ChrisDelta3Robotics/ESPiderman/STEP/BodyLid.step

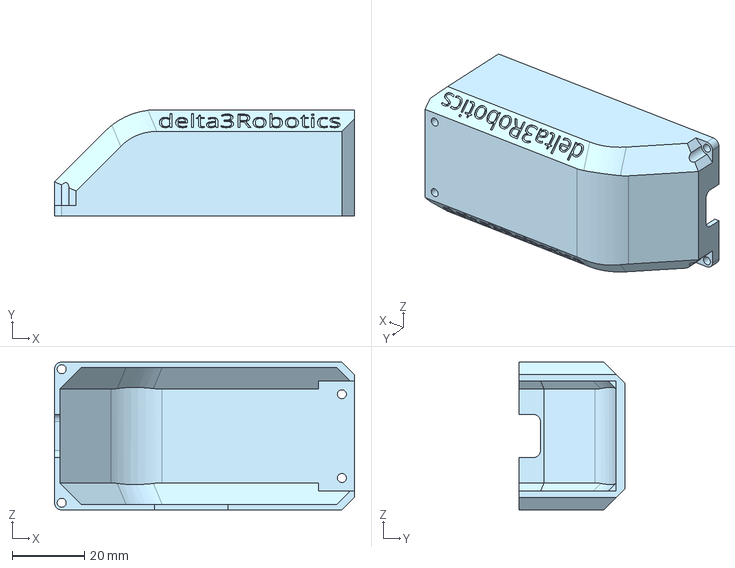
[picture p25: CAD file, 2025-09-30]
STEP/BodyLid.step
83.1 x 29.5 x 41.0 mm
