ChrisDelta3Robotics/ESPiderman/STL/cap2.stl

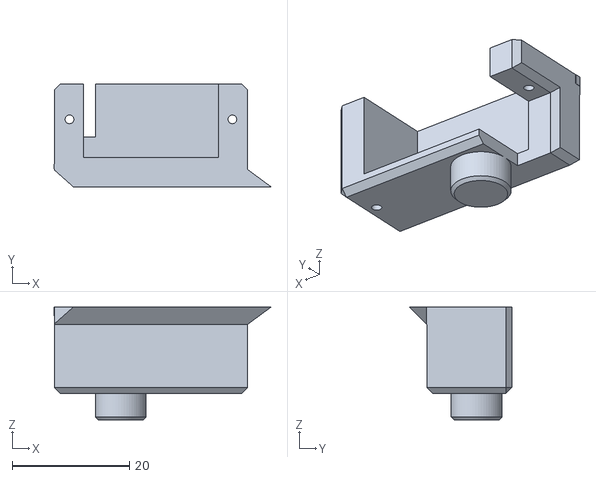
[picture p26: CAD file, 2025-09-30]
STL/cap2.stl
37.0 x 17.5 x 19.2
