ChrisDelta3Robotics/ESPiderman/STEP/Leg_OuterPart.step

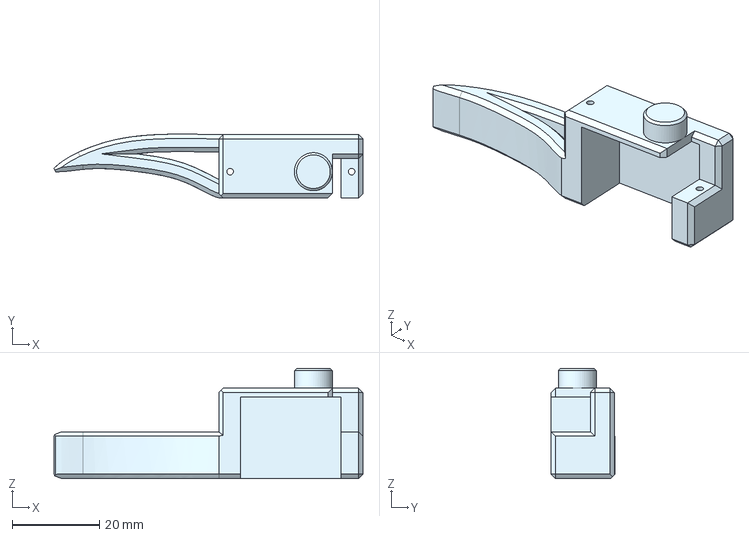
[picture p27: CAD file, 2025-09-30]
STEP/Leg_OuterPart.step
70.7 x 14.6 x 25.2 mm
