ChrisDelta3Robotics/ESPiderman/STL/cap1.stl

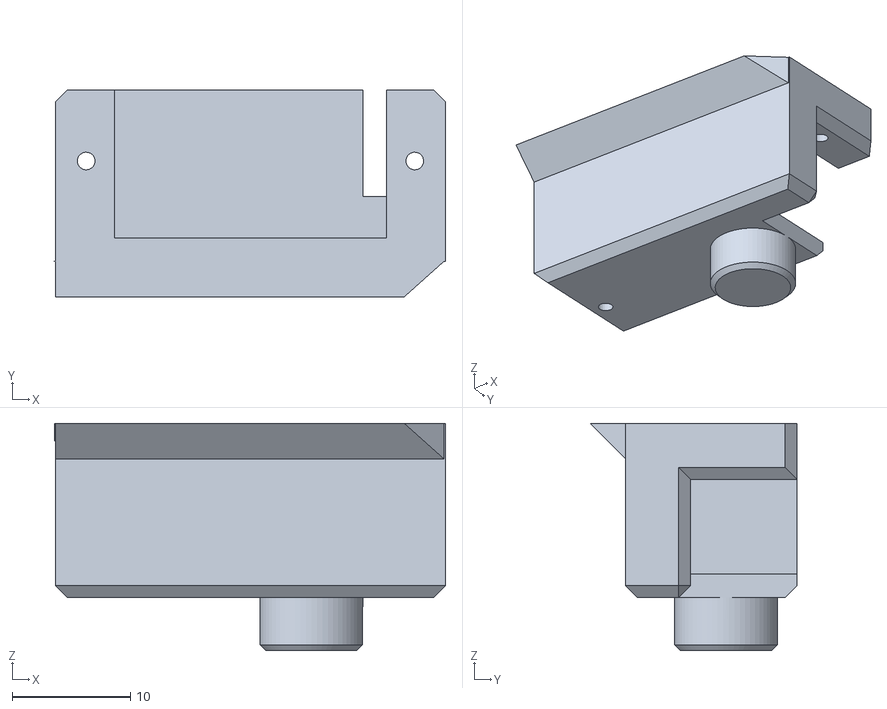
[picture p28: CAD file, 2025-09-30]
STL/cap1.stl
33.1 x 17.5 x 19.2
