ChrisDelta3Robotics/ESPiderman/STEP/Head.step

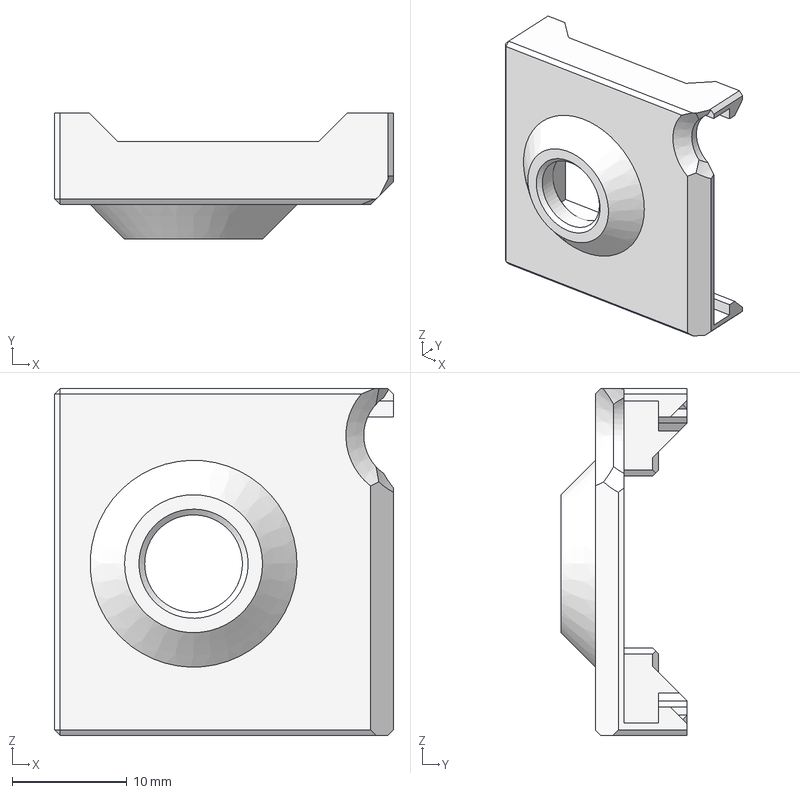
[picture p29: CAD file, 2025-09-30]
STEP/Head.step
29.5 x 11.0 x 30.2 mm
