ChrisDelta3Robotics/ESPiderman/STEP/Leg_U_Part.step

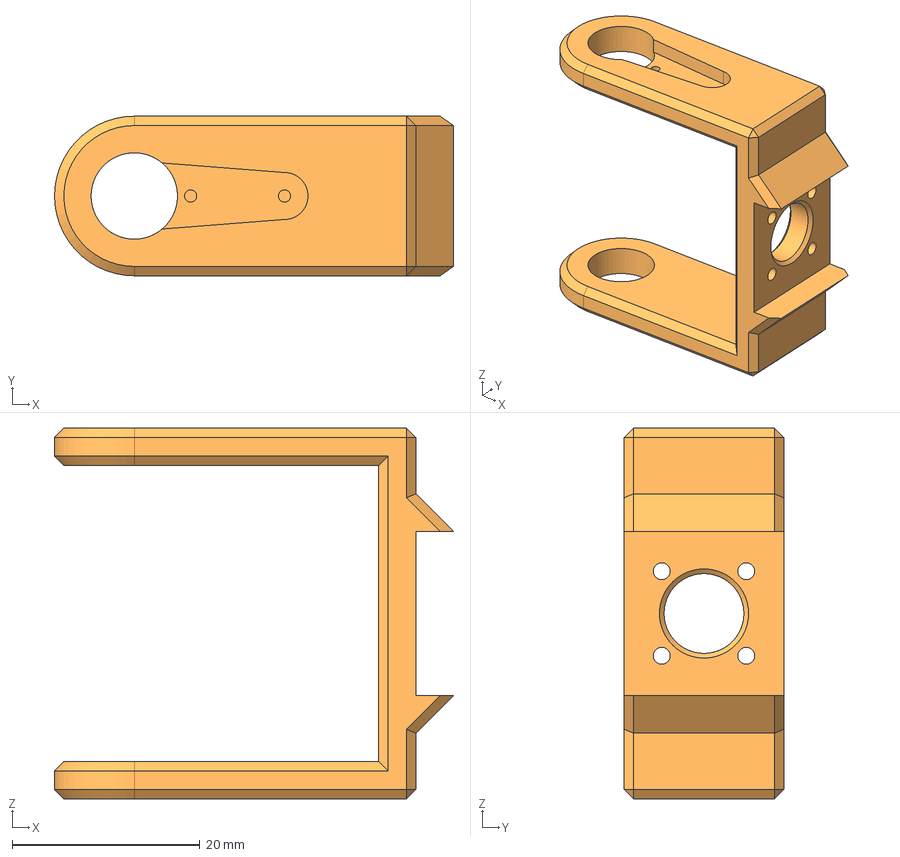
[picture p30: CAD file, 2025-09-30]
STEP/Leg_U_Part.step
42.5 x 17.0 x 39.5 mm
