ChrisDelta3Robotics/ESPiderman/STEP/Body.step

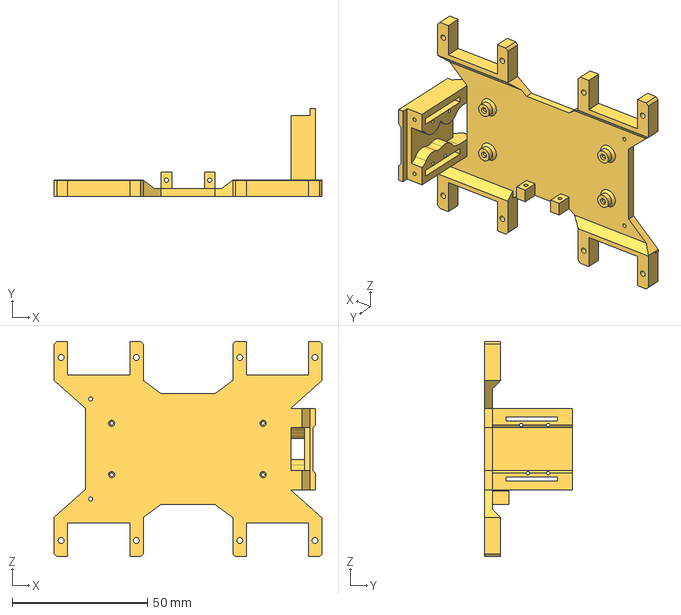
[picture p31: CAD file, 2025-09-30]
STEP/Body.step
99.1 x 32.5 x 79.7 mm
