ChrisDelta3Robotics/ESPiderman/(list of files, cad)

Other CAD files:
STEP/CapLeft.step
STEP/CapRight.step
STL/BodyLid.stl
STL/Head.stl
STL/LegOuterPart.stl
STL/LegUPart.stl
STL/body.stl
